Picatout/beyond-jupiter/(commit log)

2021-04-07 Ajout de init.s et forth.s abaondon de stm32eforth.s nouveau modèle forth ITC
    [kiCAD-schematic.kicad_pcb, kiCAD-schematic.sch]
2021-04-23 Ajout de 3DROP travail sur PLOT et TV-PUTC
2021-04-29 travail sur KBD-RST et BKD-LED
2021-05-11 travail sur spi-flash.s
2021-05-16 travail sur spi-flash WR-BLK ne fonctionne pas écriture erronnée
    [kiCAD-schematic.sch]
2021-05-16 travail sur spi-flash
2021-05-18 Ajout de DO,LOOP et +LOOP
2021-05-20 Rendre saisie insensible à la casse Ajout mots UPPER et VLIST
2021-05-24 factorisation de BCD+ et ajout de BCD1+
2021-05-25 Ajout des mots BCD-NEG et BCD-
2021-05-25 Ajout de BCD>BIN et BIN>BCD
2021-05-26 Ajout de la branche test pour développer float.s Ajou des mots BIN, U> Renommé NUMBER? en INT?
2021-06-02 ajout de s>d et d2/
2021-06-03 travail sur float.f et ajout de mots dans forth.s
2021-06-04 travail sur float.f Ajout de D* renommé UD/ en D/
2021-06-05 Ajout des mots **FABS**, **FNEGATE**, **FMIN**, **FMAX** , **F&gt;** et **F&lt;**.
2021-06-06 Ajout de [CHAR] et travail sur float.f et float.s
2021-06-07 travail sur trace et débogage de float?
2021-06-09 Ajout de CLZ et CTZ
2022-01-27 travail sur fpu.s et strtof.s
    [kiCAD-schematic.kicad_sch]
2022-02-04 travail sur ftoa.f et forth.s, ajout de ARRAY
2022-02-06 modification aux mots <:> et <COLON_ABORT> pour permettre les définitions récursives
2022-02-09 ajout du mot TONE
    [kiCAD-schematic.kicad_sch]
2022-02-12 codé PICK en assembleur et ajouter PUT
2022-02-13 retravaillé parsing des nombres
2022-02-13 Ajout des mots **ALIGN** , **CHAR+**, **CHARS**, **FIND**
2022-02-14 beaucoup de modificaiton, voir journal
2022-02-15 Ajout de constantes MAX-INT, MIN-INT, MAX_UINT Ajout de SM/REM et de UNLOOP Corrigé bogue mot EXIT
2022-02-15 Ajout de STATE et SOURCE
2022-02-16 Ajout de ENVIRONMENT? et constantes associées Ajout de UD.
2022-03-02 Ajout de CASE,OF,ENDOF et ENCASE
2022-03-10 ajout de blocks.s
2022-06-29 débogage de strtof.s
2024-03-08 Mise à jour schematic
    [kiCAD-schematic.kicad_sch]
2024-03-12 modification de IF-SENSE
    [kiCAD-schematic.kicad_sch]
2024-03-14 réécritures de l'analyseur numérique
2024-03-14 Modification de F. pour supprimer l'argument d réécriture de IPART et FPART
2024-03-14 mise à jour readme.md
    [kiCAD-schematic.kicad_sch]
